NickMateus11/Bluetooth-Keypad/images/IMG_20210902_143353.jpg

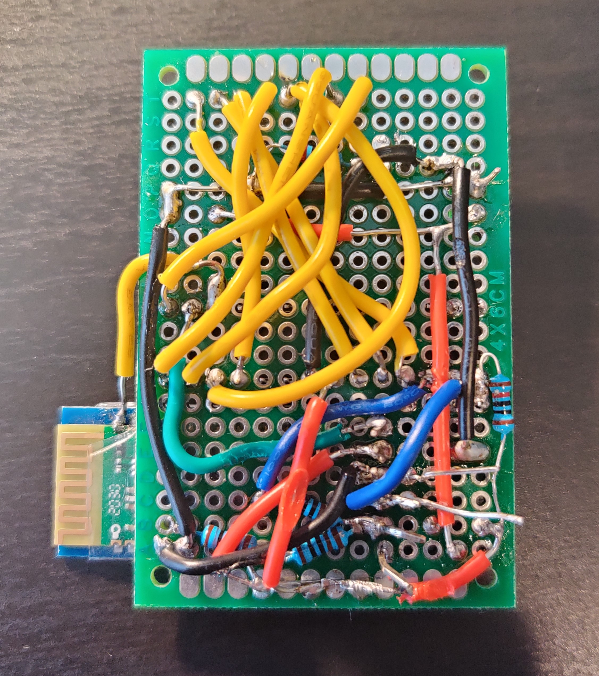
images/IMG_20210902_143353.jpg
