NickMateus11/Bluetooth-Keypad/(commit log)

2021-08-27 add debug prints
2021-08-29 swap roles test working - memory leaks as hell though
    [ArduinoSleep.cpp, ArduinoSleep.h, BluetoothModule.cpp, BluetoothModule.h, Bluetooth_Keypad.ino, Keypad.cpp, Keypad.h]
2021-08-29 read() fixes - TODO: remove String reliance everywhere
    [BluetoothModule.cpp, BluetoothModule.h]
2021-08-31 #define project parameters - partial setup for power saving
2021-08-31 Interrupts, power saving, bluetooth keypad working
